L-Sewel/Hybrid-Controls-System/images/MULE-1_PID_for_GUI.png

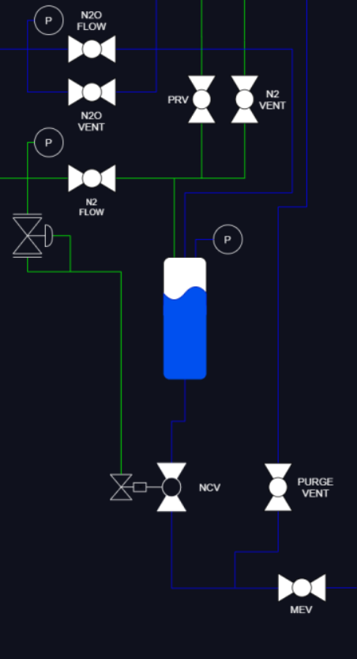
images/MULE-1_PID_for_GUI.png
