L-Sewel/Hybrid-Controls-System/images/system_diagram.png

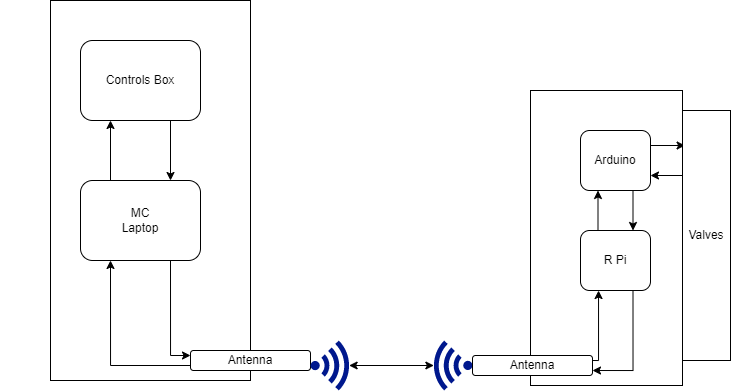
images/system_diagram.png
