L-Sewel/Hybrid-Controls-System/src/MCB/PDPMCBCircuit/PDPMCBCircuit.kicad_pcb

## KiCad design PCB.sch


Parts:
C1, C4, C5: 100nF; C_Disc_D4.7mm_W2.5mm_P5.00mm
C2, C6: 330nF; CP_Radial_D4.0mm_P1.50mm
C3: 2,2uF; CP_Radial_D4.0mm_P1.50mm
D1: RED~2V; LED_D3.0mm
D2: BLUE~3.2V; LED_D3.0mm
D3: GREEN~2.5V; LED_D3.0mm
D4: VIOLET~3.6V; LED_D3.0mm
J1: Power_Connectors; PinSocket_1x08_P1.27mm_Vertical
L7809CV: Reg 9V; TO-220-3_Vertical; DigiKey 497-1448-5-ND
LF33CV: Reg 5V; TO-220-3_Vertical; DigiKey 497-7313-5-ND
LM7805ACT: Reg 3V3; TO-220-3_Vertical; DigiKey LM7805ACT-ND
R1, R2: 100; R_Axial_DIN0411_L9.9mm_D3.6mm_P15.24mm_Horizontal
R3, R4: 470; R_Axial_DIN0411_L9.9mm_D3.6mm_P15.24mm_Horizontal
Switch1, Switch2, Switch3, Switch4: On_Off; SW_DIP_SPSTx01_Slide_9.78x4.72mm_W7.62mm_P2.54mm

Connections:
+12C: Switch1.1 (A), Switch2.1 (A), Switch3.1 (A), Switch4.1 (A)
GND: C1.2, C2.2, C3.2, C4.2, J1.2, J1.4, J1.6, J1.8, LF33CV.2 (GND), LM7805ACT.2 (GND), R1.2, R2.2, R3.2, R4.2
unnamed: C1.1, D1.2 (A), J1.1, LM7805ACT.3 (VO)
unnamed: C2.1, LM7805ACT.1 (VI), Switch1.2 (B)
unnamed: C3.1, D2.2 (A), J1.3, LF33CV.3 (VO)
unnamed: C4.1, LF33CV.1 (VI), Switch2.2 (B)
unnamed: C5.1, D3.2 (A), J1.5, L7809CV.3 (OUT)
unnamed: C5.2, C6.2, L7809CV.2 (GND)
unnamed: C6.1, L7809CV.1 (IN), Switch3.2 (B)
unnamed: D1.1 (K), R1.1
unnamed: D2.1 (K), R2.1
unnamed: D3.1 (K), R3.1
unnamed: D4.1 (K), R4.1
unnamed: D4.2 (A), J1.7, Switch4.2 (B)
