L-Sewel/Hybrid-Controls-System/src/Controls/Valve.cpp

#include "Valve.h" 

    // Constructor
    Valve::Valve(int upperBound, int lowerBound){
    this->upperBound = upperBound;
    this->lowerBound = lowerBound;
    }

    //*********State functions*********
    int Valve::state(){
      if(digitalRead(upperBound) == LOW){
          return -1;
        }else if(digitalRead(lowerBound) == LOW){
          return 1;
        }else{
          return 0;
          }
      }

    String Valve::strState(){
      if(digitalRead(upperBound) == LOW){
        return "Open";
      }else if(digitalRead(lowerBound) == LOW){
        return "Closed";
      }else{
        return "Unknown";
        }
      }

    //*********Getters*********
    int Valve::getUpperbound(){
    return this->upperBound;
    }

    int Valve::getlowerBound(){
    return this->lowerBound;     
    }
