L-Sewel/Hybrid-Controls-System/(commit log)

2022-09-07 Valve Cart Controls version updated during launch Canada competition primary changes related to Functionality as a stand alone system.
2023-02-11 Driver And Limit Pin Confermations; Motor tunning
